waihekor/Rubik-Robot/README.md

# Rubik-Robot
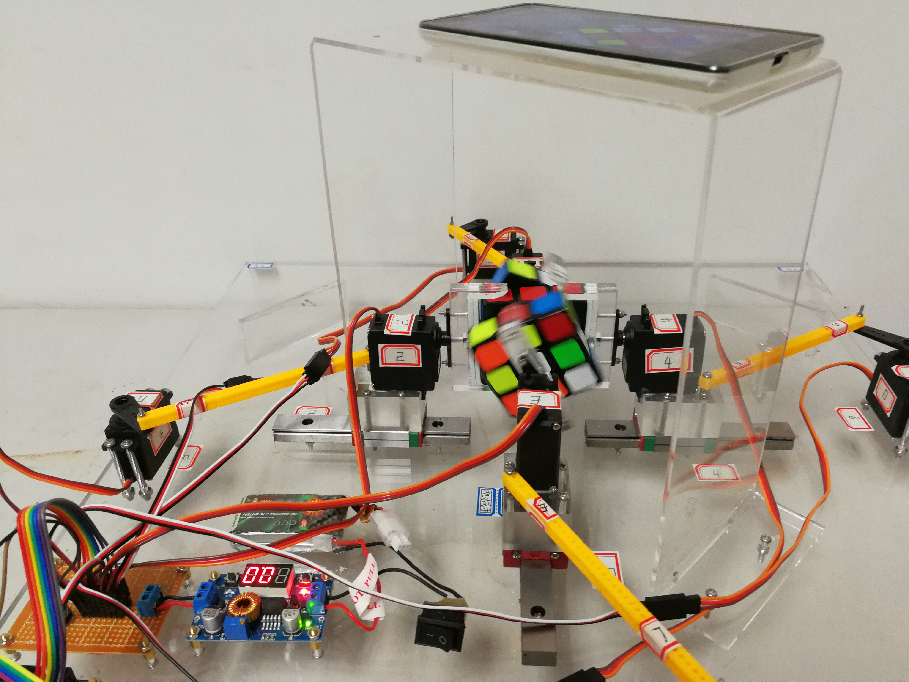
[picture p1: Photos/Robot/5.jpg]
