waihekor/Rubik-Robot/Drawing/亚克力定制要求.pdf

图纸中所有单位均为 mm，比例为 1：1， 机械手为黑色亚克力材质（ 考虑到

手机 APP 自动识别精度）， 其它为透明亚克力材质。

要求：

1.滑块增高块厚度为 30mm，数量 4 个。

2.机械手厚度为 10mm，数量 4 个。

3.手机支架厚度为 3mm，数量 1 个。（备注：需要弯折）

4.基板厚度为 8mm，数量 1 个。

5.基板支撑块， 数量 4 个。

备注：基板支撑块很简单，没有图纸，参考设计：长 100mm，宽 40mm，厚度

8mm。

# 子非鱼科技网店
