waihekor/Rubik-Robot/Drawing/其它/定制要求.pdf

图纸中所有单位均为 mm
要求：

1.机械手厚度为 10mm，数量 4 个。(透明亚克力)
2.基板厚度为 6mm，数量 1 个。 （透明亚克力） 3.最后一个很简单，没有图纸，长 100mm，宽 40mm，厚度 8mm。（透明亚克力）
