waihekor/Rubik-Robot/Algorithm/Automatic Identification/两种类型的魔方.pdf

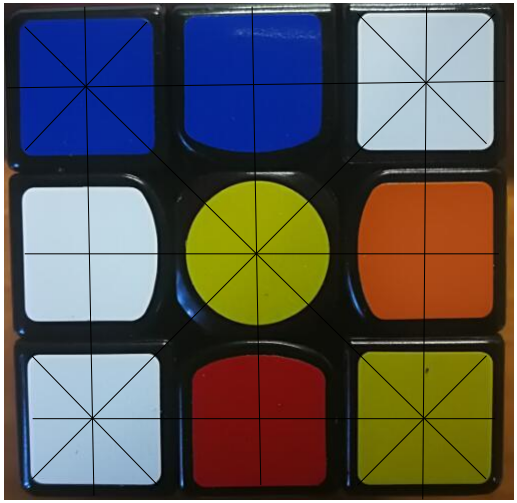
[picture p2: figure]

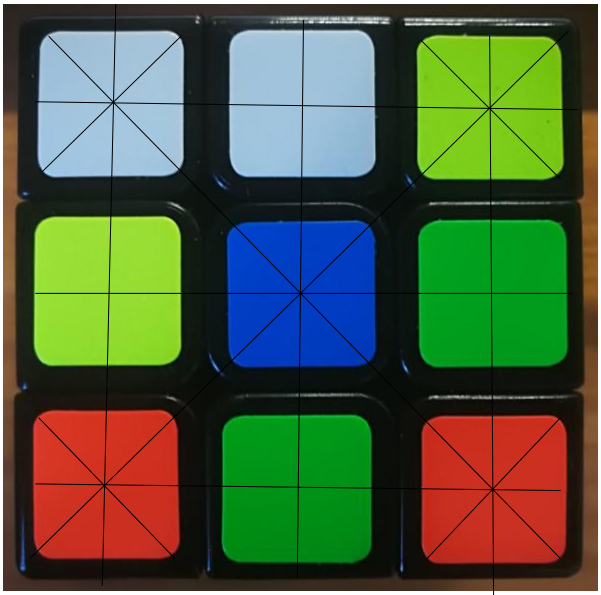
[picture p3: figure]
