waihekor/Rubik-Robot/Photos/Robot/1.jpg

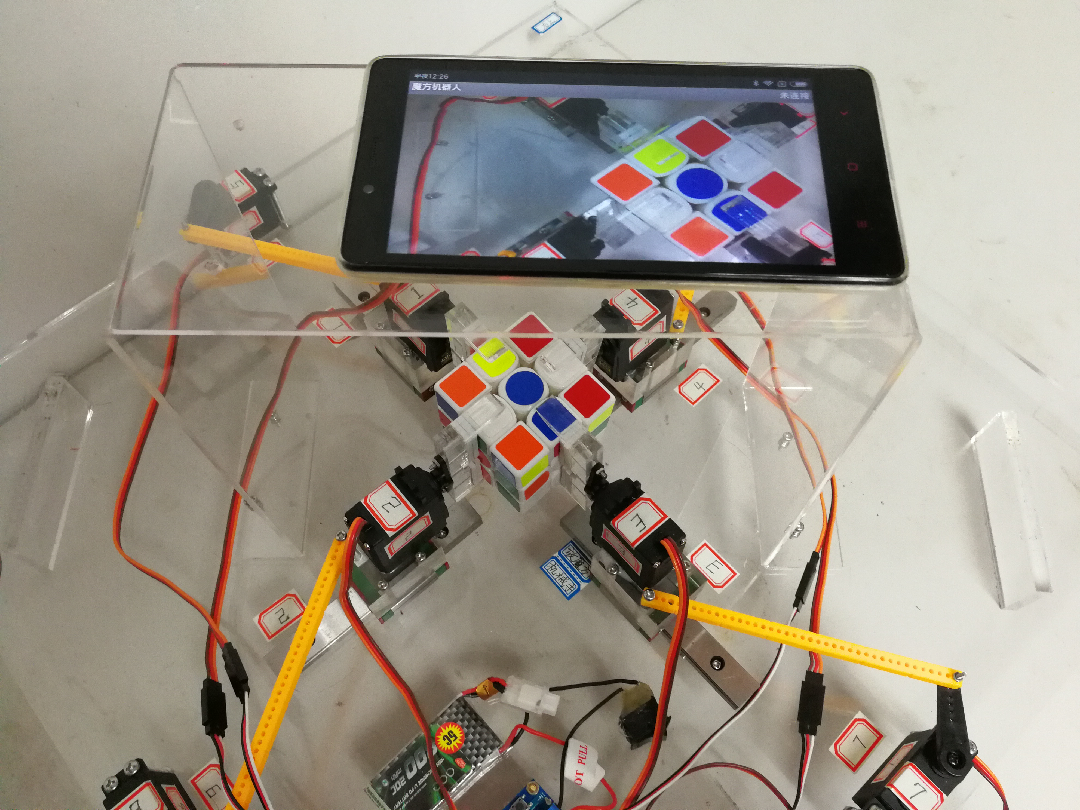
Photos/Robot/1.jpg
