waihekor/Rubik-Robot/Photos/Robot/2.jpg

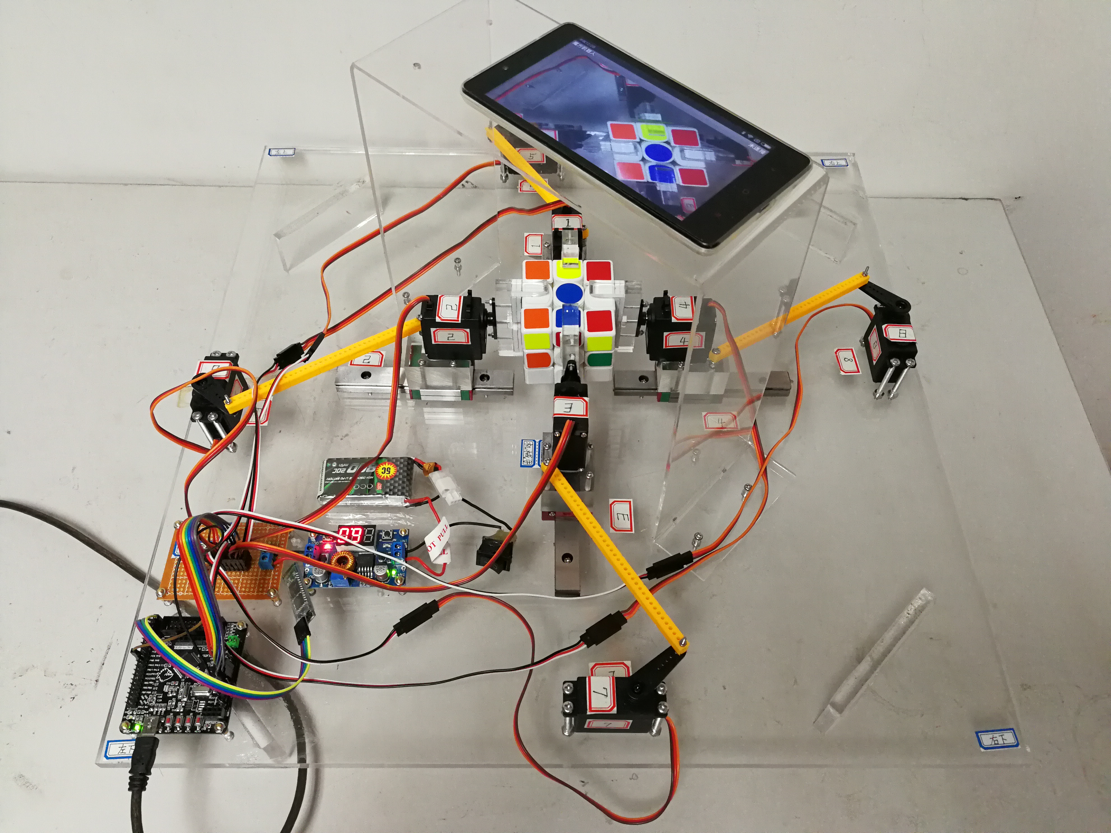
Photos/Robot/2.jpg
