waihekor/Rubik-Robot/Photos/Robot/3.jpg

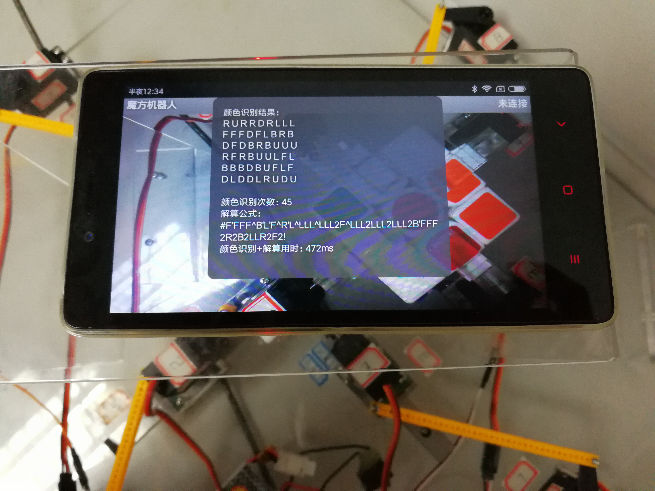
Photos/Robot/3.jpg
