waihekor/Rubik-Robot/Photos/Robot/4.jpg

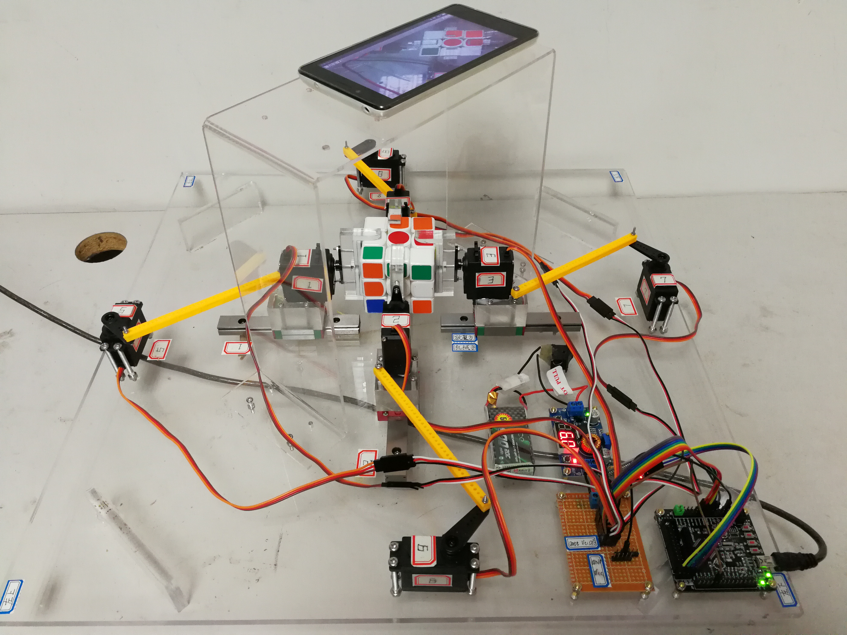
Photos/Robot/4.jpg
