waihekor/Rubik-Robot/Photos/SD Card/1.jpg

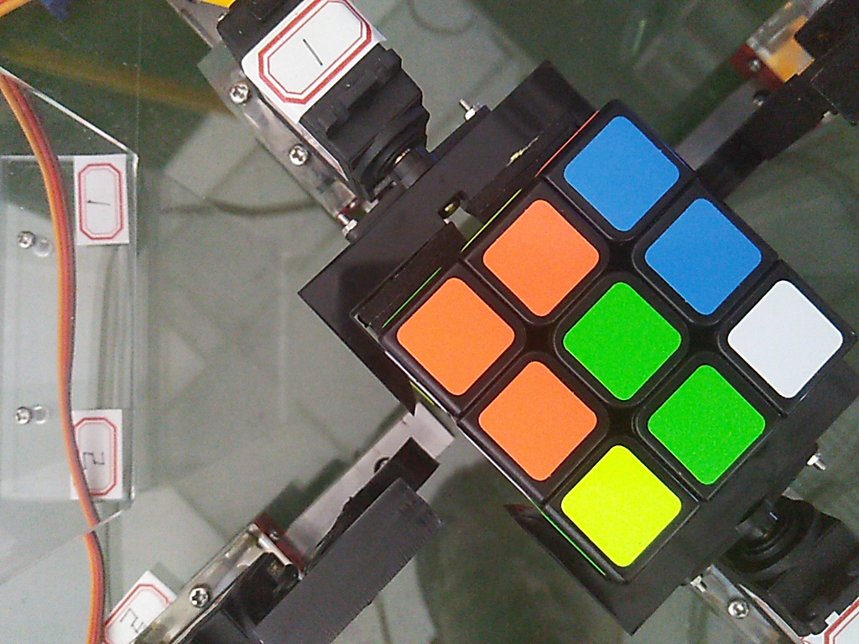
Photos/SD Card/1.jpg
