waihekor/Rubik-Robot/Photos/SD Card/2.jpg

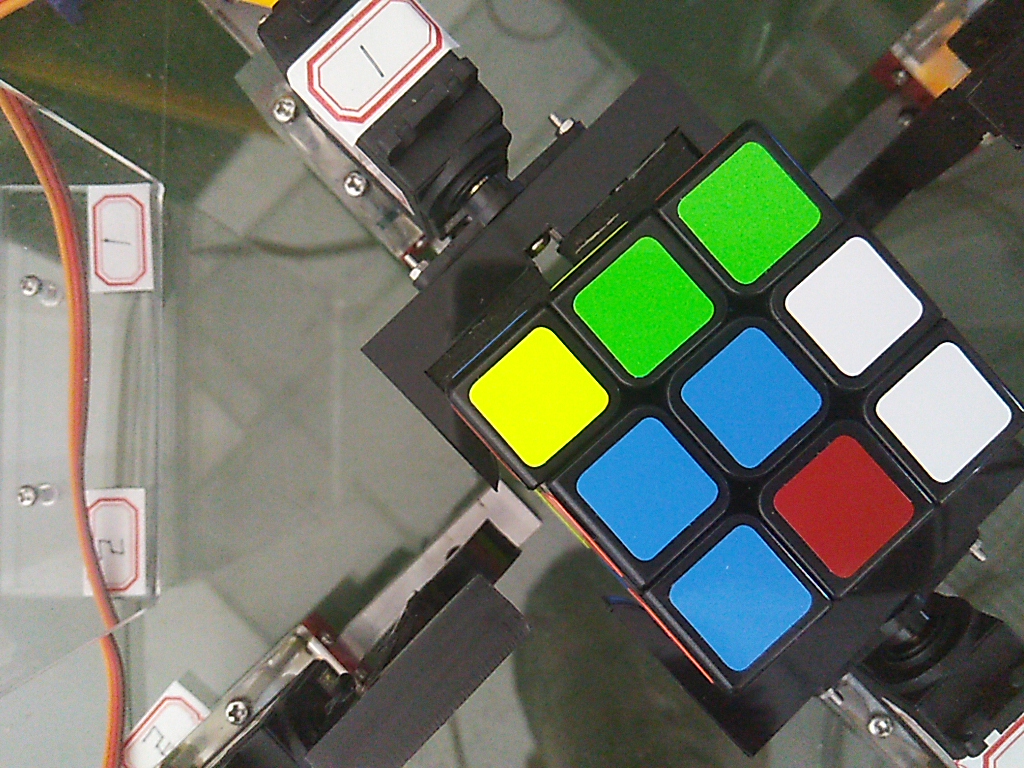
Photos/SD Card/2.jpg
