waihekor/Rubik-Robot/Photos/SD Card/3.jpg

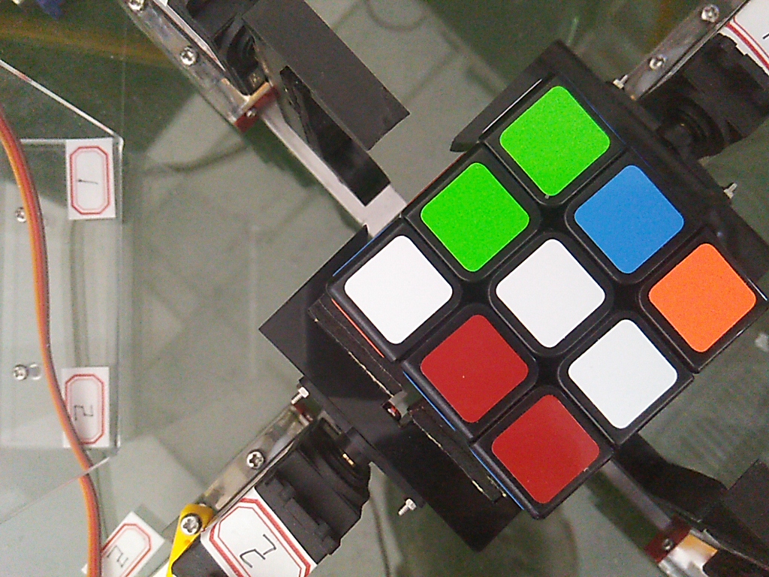
Photos/SD Card/3.jpg
