waihekor/Rubik-Robot/Photos/SD Card/4.jpg

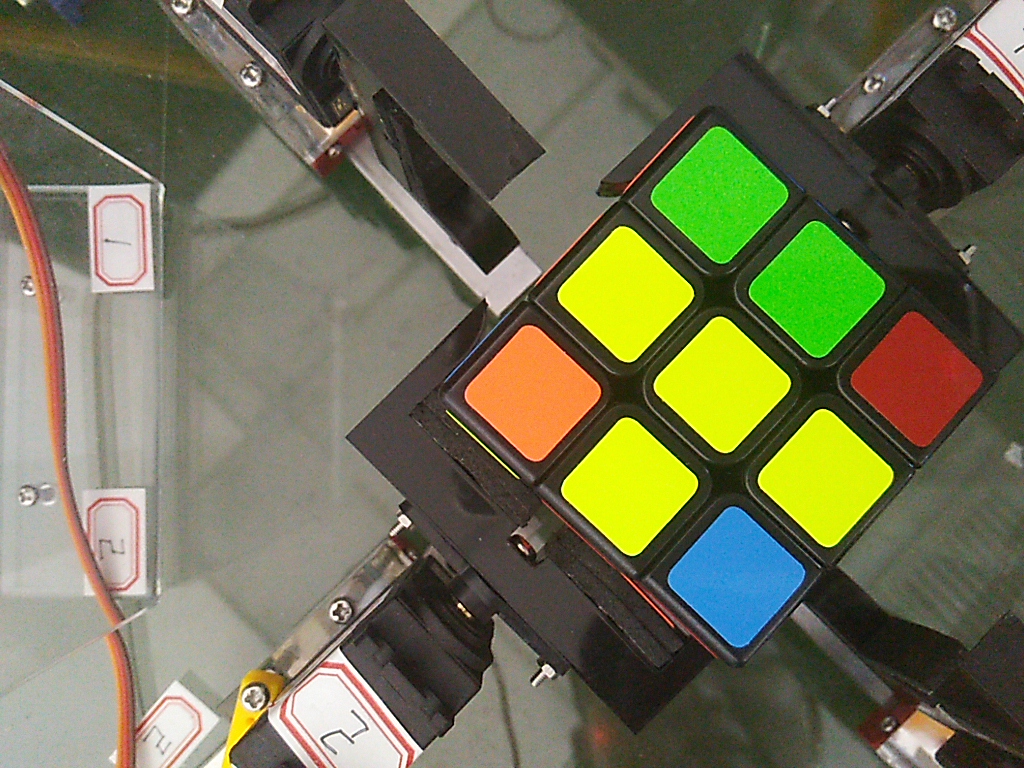
Photos/SD Card/4.jpg
