waihekor/Rubik-Robot/Photos/SD Card/5.jpg

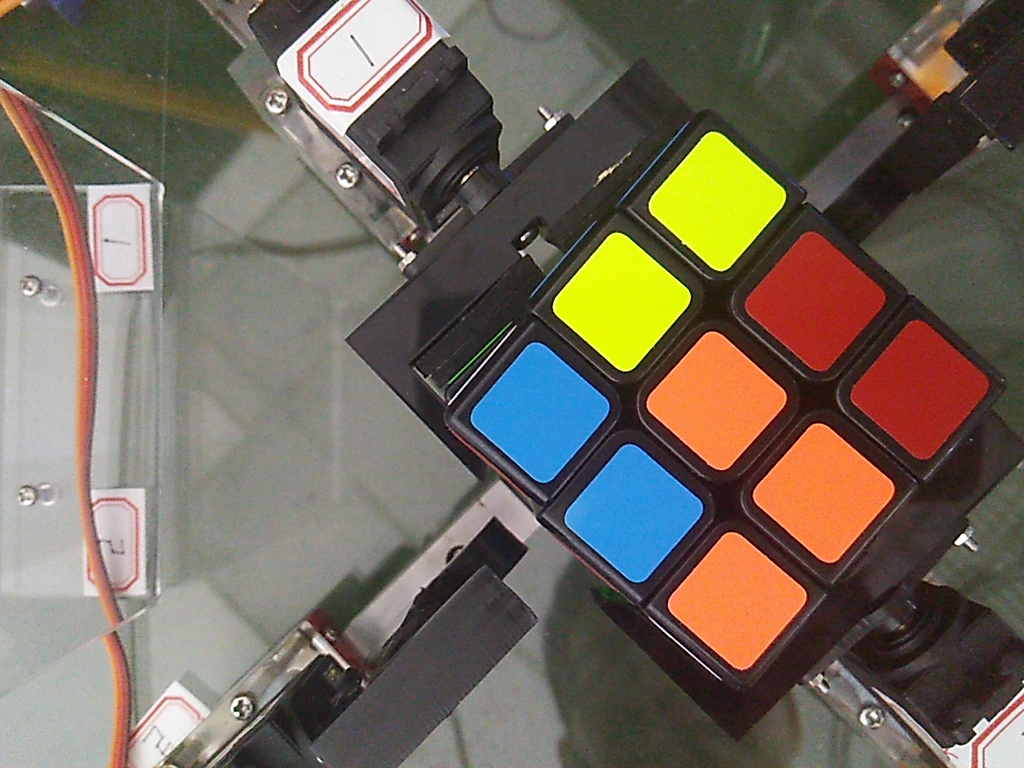
Photos/SD Card/5.jpg
