waihekor/Rubik-Robot/Photos/SD Card/6.jpg

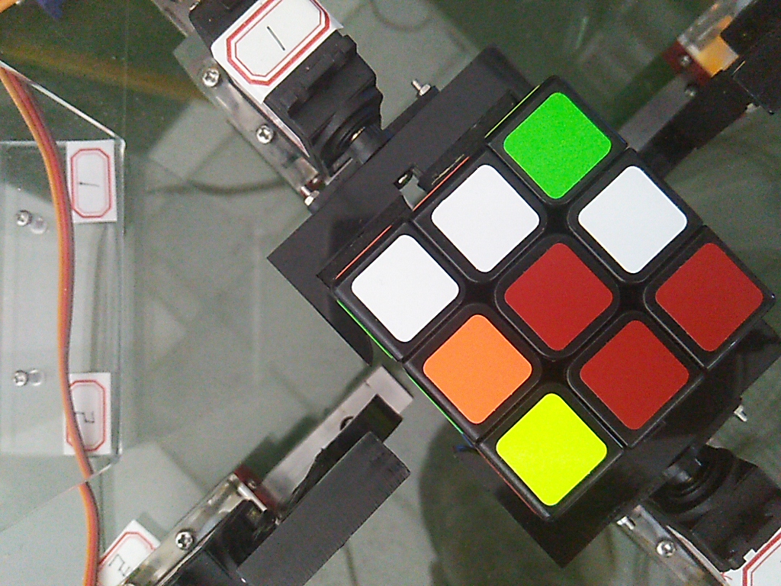
Photos/SD Card/6.jpg
