waihekor/Rubik-Robot/(list of files, cad)

Other CAD files:
Drawing/其它/机械手.DWG
Drawing/手机支架.DWG
Drawing/其它/基板.DWG
Drawing/机械手.DWG
Drawing/基板.DWG
Drawing/滑块增高块.DWG
