waihekor/Rubik-Robot/Tutorial/系统搭建/电路搭建/蓝牙串口模块设置教程.pdf

全套硬件套餐中使用的蓝牙串口模块型号为 HC-05，其采用蓝牙 2.0 通信协议。蓝牙串 口模块使用了蓝牙芯片的透传功能，可以实现蓝牙协议和串口协议之间的转换，不需要了解 蓝牙协议就可以实现数据的无线收发，非常方便，其也叫做无线串口。 蓝牙串口模块使用 AT 指令来设置其参数，例如蓝牙名称，蓝牙配对密码等。针对我们 的硬件套餐提供的蓝牙串口模块，下面我们介绍其参数设置方法，如果不对其参数进行设置， 蓝牙串口模块无法正常工作。我们提供的蓝牙串口模块如下图所示。

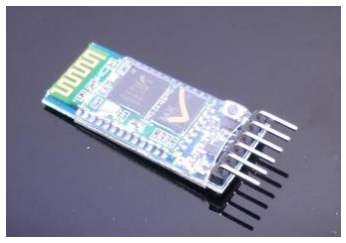
[picture p22: figure]
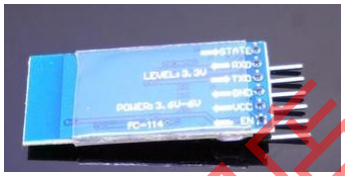
[picture p23: figure]

蓝牙串口模块正面 | 蓝牙串口模块背面

在设置前，我们需要准备一个 USB 转 TTL 模块，单片机下载程序一般会用到这种模块， 如下图所示。

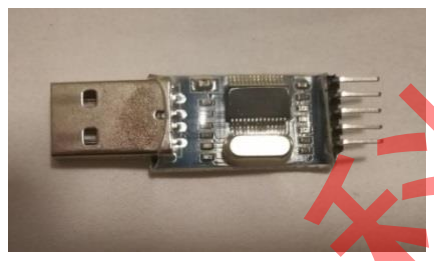
[picture p24: figure]
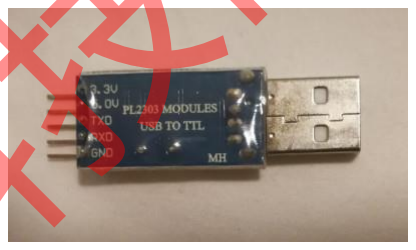
[picture p25: figure]

USB 转 TTL 模块正面 | USB 转 TTL 模块背面

第一步需要用杜邦线把 USB 转 TTL 模块和蓝牙串口模块连接在一起，各用双方的四根 线，分别为 VCC(5.0V)， GND(电源负极)，TXD(串口发送端口)，RXD（串口接收端口），双 方的连接方式为：

USB 转 TTL 模块 | 蓝牙串口模块
5.0V | POWER 3.6V-6.0V
GND | GND
TXD | RXD
RXD | TXD

第二步，按住蓝牙串口模块上的一个黑色按键，并把 USB 转 TTL 模块插在电脑的 USB 口上，直到蓝牙串口模块上的灯的状态由快闪变为慢闪，这时松开按键，此时就可以使用 AT 指令了。插上 USB 转 TTL 模块之后通过电脑设备管理器可以查询到串口端口号，如下图所 示，我们要记住这个端口号。

# 子非鱼科技网店

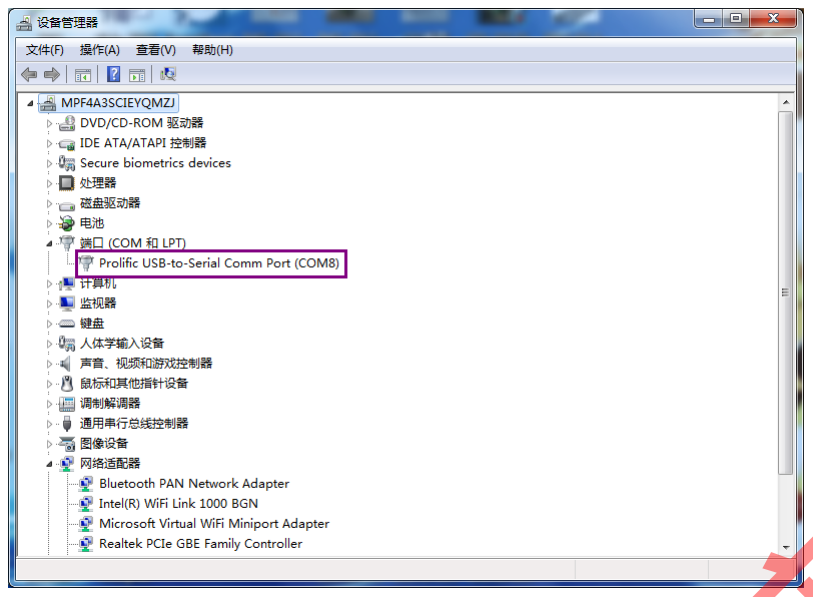
[picture p26: figure]
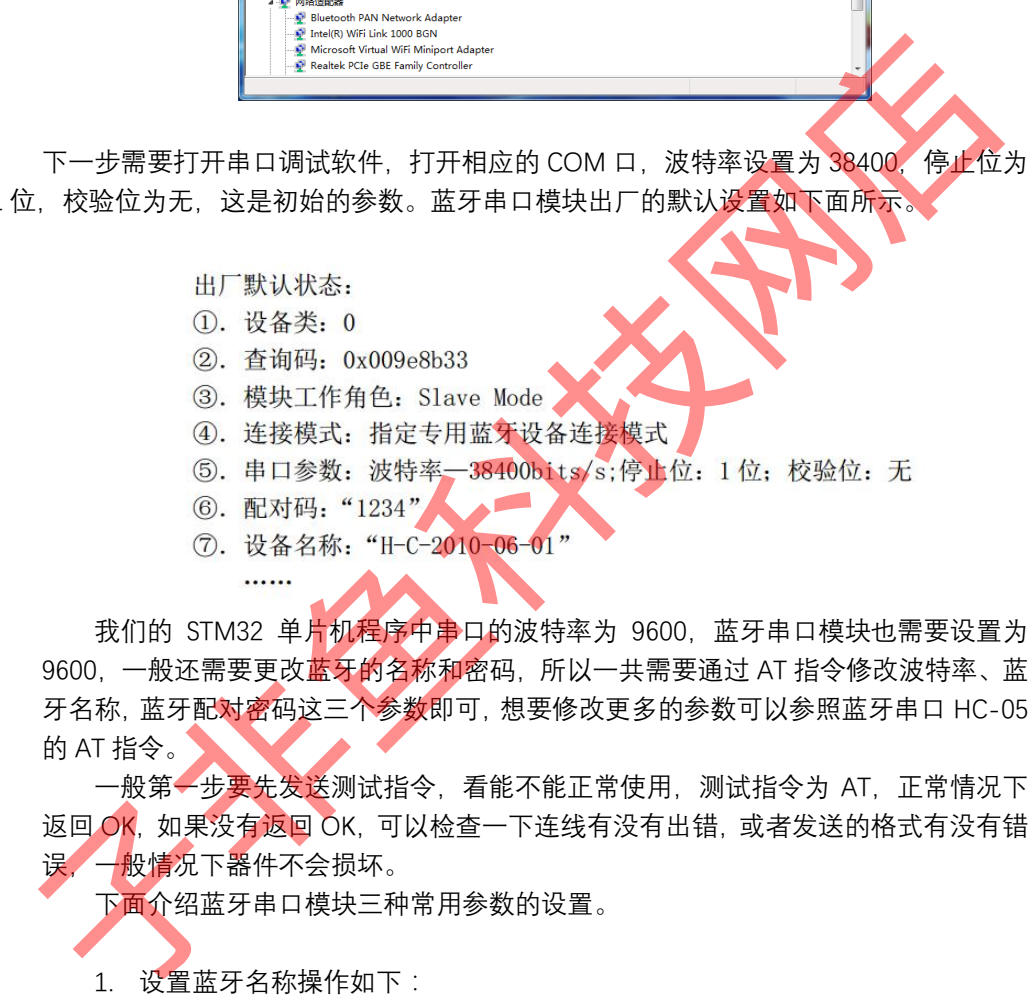
[picture p27: figure]
子非鱼科技网店; 设置蓝牙名称操作如下：

下一步需要打开串口调试软件，打开相应的 COM 口，波特率设置为 38400，停止位为 1 位，校验位为无，这是初始的参数。蓝牙串口模块出厂的默认设置如下面所示。

我们的 STM32 单片机程序中串口的波特率为 9600，蓝牙串口模块也需要设置为 9600，一般还需要更改蓝牙的名称和密码，所以一共需要通过 AT 指令修改波特率、蓝 牙名称，蓝牙配对密码这三个参数即可，想要修改更多的参数可以参照蓝牙串口 HC-05 的 AT 指令。
一般第一步要先发送测试指令，看能不能正常使用，测试指令为 AT，正常情况下 返回 OK，如果没有返回 OK，可以检查一下连线有没有出错，或者发送的格式有没有错 误，一般情况下器件不会损坏。
下面介绍蓝牙串口模块三种常用参数的设置。

1.

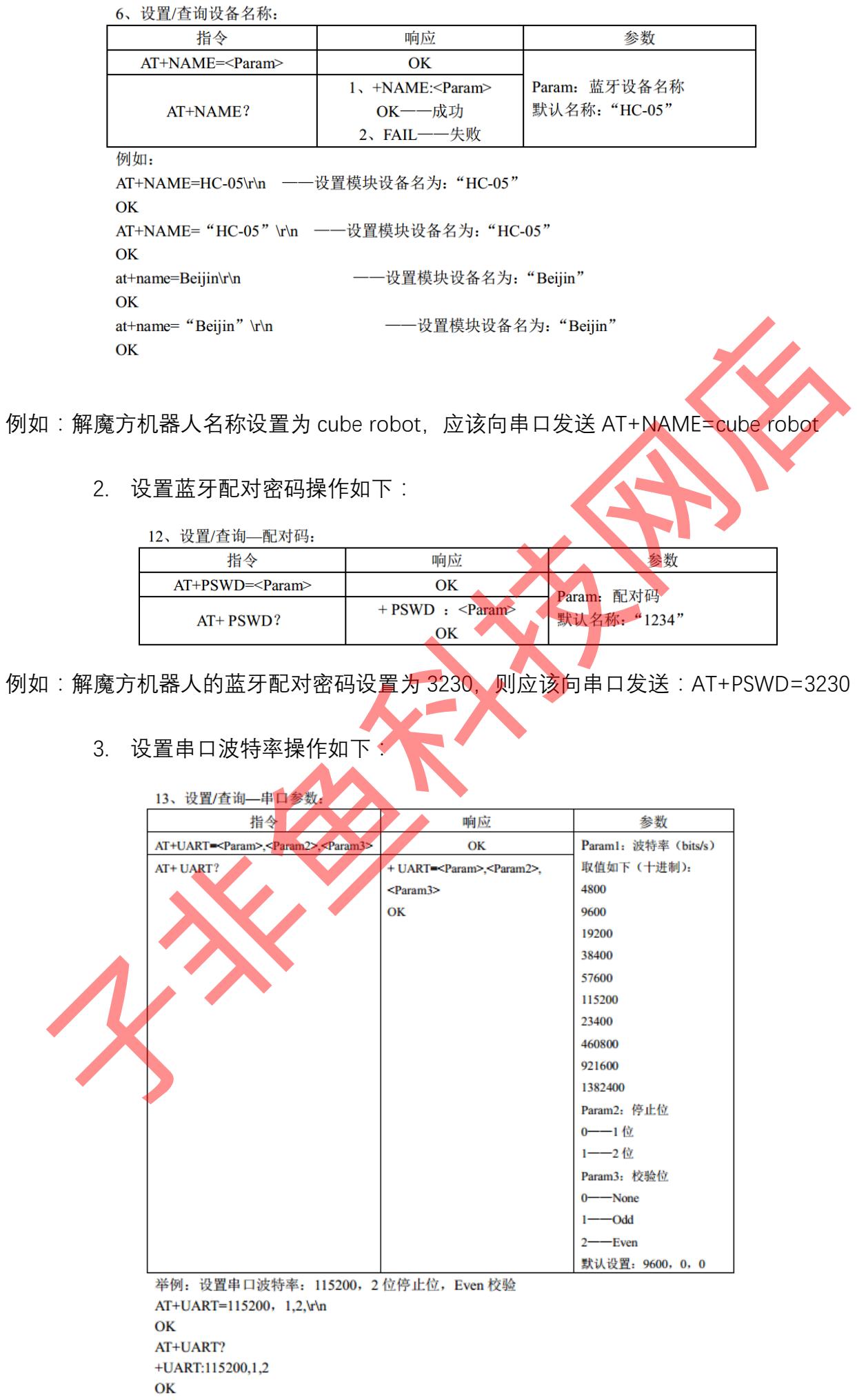
[picture p28: page 3]

例如：解魔方机器人名称设置为 cube robot，应该向串口发送 AT+NAME=cube robot

2. 设置蓝牙配对密码操作如下：

例如：解魔方机器人的蓝牙配对密码设置为 3230，则应该向串口发送：AT+PSWD=3230

3. 设置串口波特率操作如下：

# 子非鱼科技网店

例如：解魔方机器人的串口波特率设置为 9600，应该向串口发送： AT+UART=9600,0,0

# 子非鱼科技网店
