waihekor/Rubik-Robot/Tutorial/系统搭建/电路搭建/解魔方机器人电路介绍与搭建教程.pdf

整个解魔方机器人的电路系统由以下几部分组成：STM32 最小系统板、舵机插接板、锂 电池、蓝牙串口模块、大电流稳压模块，舵机，各个模块的图片如下图所示。

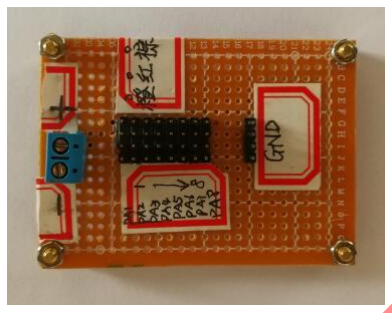
[picture p29: figure]
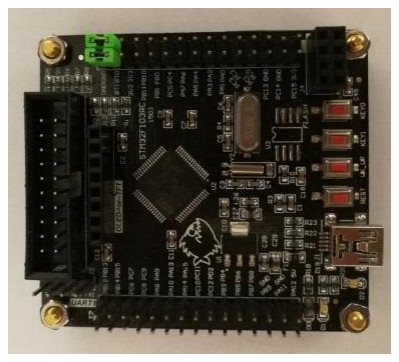
[picture p30: figure]

STM32 最小系统板 | 舵机插接板

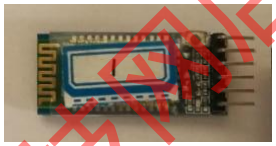
[picture p31: figure]
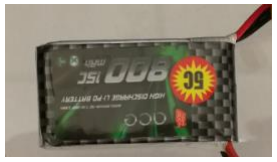
[picture p32: figure]

锂电池 | 蓝牙串口模块

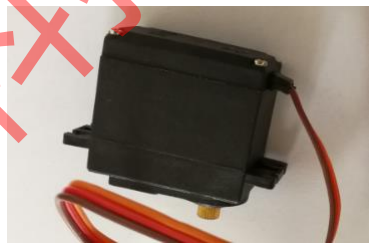
[picture p33: figure]
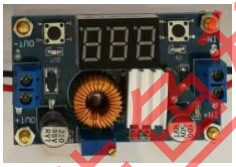
[picture p34: figure]

大电流稳压模块 | 舵机

解魔方机器人有两套电源供应系统，锂电池通过大电流稳压模块单独为舵机供电，USB 数据线为 STM32 最小系统板供电。
锂电池的标称电压为 7.2V，充满电可以达到 8V 以上，最大输出电流可达 12A，完全可 以满足舵机驱动的电流和压电要求。
MG995 舵机的供电电压一般为 4.8V-7.2V，每个舵机在工作时的电流要大于 500mA，8 个舵机需要至少 4A 的电流，全套硬件套餐中提供的大电流稳压模块能够提供最大 5A 的电 流，该款稳压模块可以通过调节电位器调节输出电压的值，电位器顺时针为升压，逆时针为 降压，我们一般调节输出电压到 6V，关于该款稳压模块更多功能的介绍见下图。

# 子非鱼科技网店

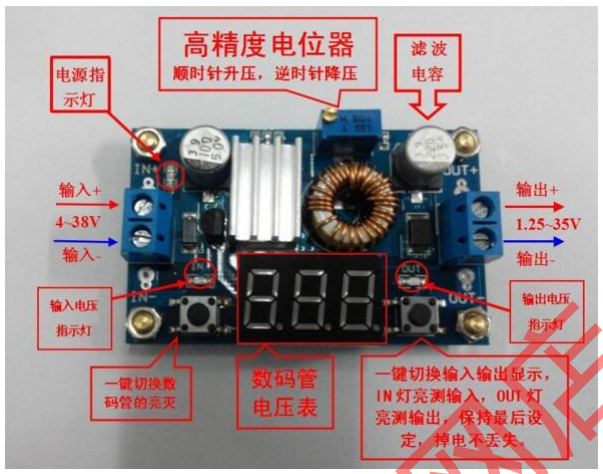
[picture p35: figure]

大电流稳压模块功能介绍

舵机有三根线，橙色为数据线，红色为电源正极，棕色为电源负极，数据线需要连接 STM32 相应端口，通过编程让 STM32 来控制其角度。舵机插接板为洞洞板手工焊接，正面 和背面如图所示。

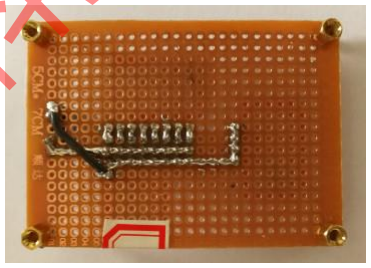
[picture p36: figure]
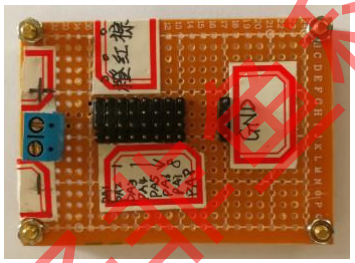
[picture p37: figure]

插接板正面 | 插接板背面

图中从左到右，1 号舵机到 8 号舵机的数据线分别连接 STM32 的 PA1 到 PA8，锂电池 的电源地和 STM32 的地可以不用连接，这样锂电池电源和 STM32 供电系统没有任何耦合， 即上图中的标识 GND 可以不用。从图中可以很清晰看到，从上到下有四排排针，每排有 8 根，对应 8 个舵机。前三排排针连接舵机用，从上到下分别连接舵机的电源负极、电源正极 和数据线，可以看到第三排排针和第四排排针是上面相通的，第四排排针是通过杜邦线把舵 机的数据线和单片机的 P 对应端口相连。舵机和舵机插接板的连接示意图如下图所示。

# 子非鱼科技网店

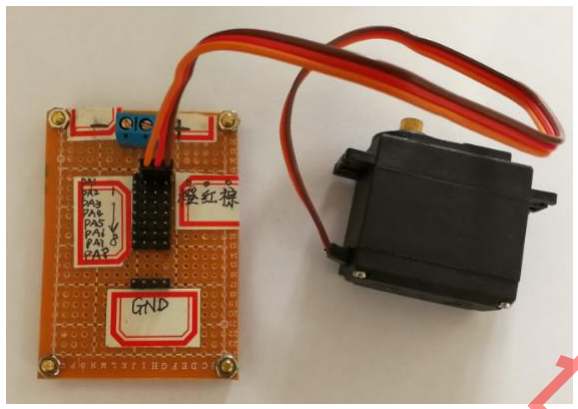
[picture p38: figure]
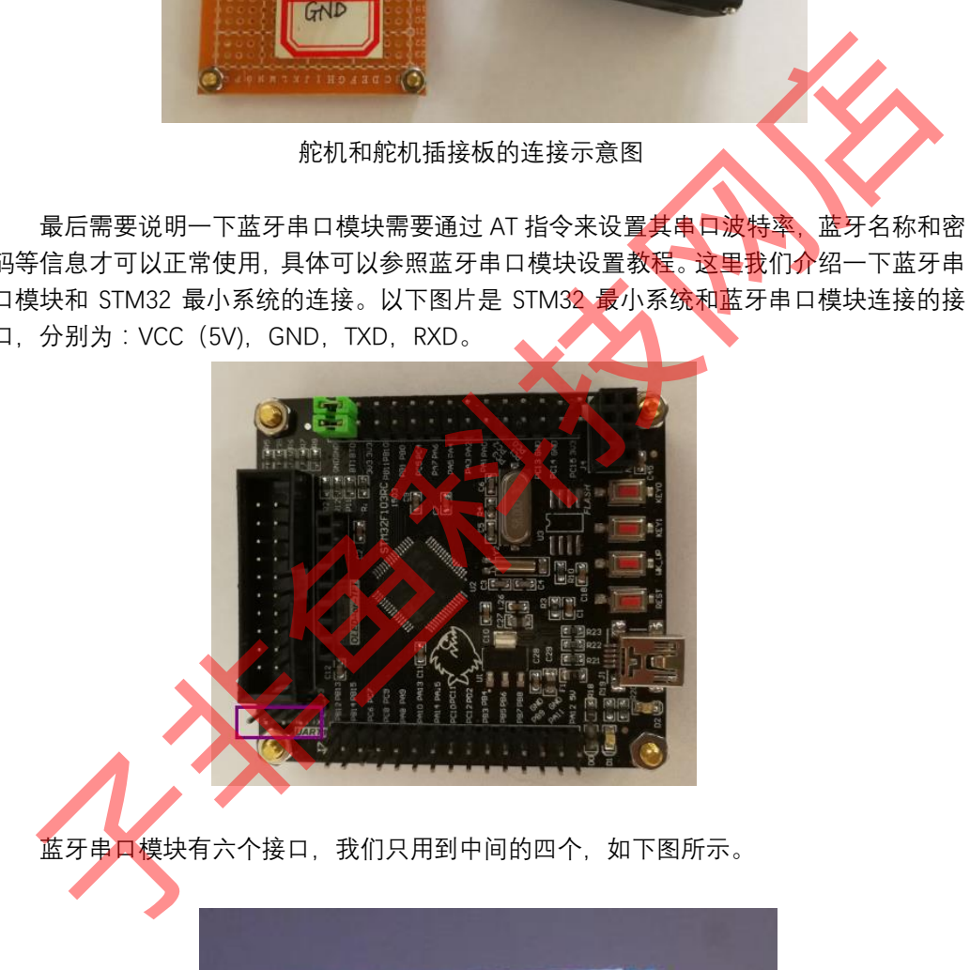
[picture p39: figure]
子非鱼科技网店

舵机和舵机插接板的连接示意图

最后需要说明一下蓝牙串口模块需要通过 AT 指令来设置其串口波特率，蓝牙名称和密 码等信息才可以正常使用，具体可以参照蓝牙串口模块设置教程。这里我们介绍一下蓝牙串 口模块和 STM32 最小系统的连接。以下图片是 STM32 最小系统和蓝牙串口模块连接的接 口，分别为：VCC（5V)，GND，TXD，RXD。

蓝牙串口模块有六个接口，我们只用到中间的四个，如下图所示。

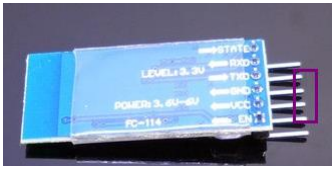
[picture p40: figure]

两者的连接关系为：

VCC-------------------------------VCC GND---------------------------- --GND TXD-------------------------------RXD RXD-------------------------------TXD

两者用杜邦线连接起来，杜邦线是一一对应的，并不存在杜邦线交叉的情况，线路连接 还是比价清晰的。

# 子非鱼科技网店
