waihekor/Rubik-Robot/Tutorial/视频教程/解魔方机器人有关视频.pdf

解魔方机器人工作视频

第一版解魔方机器人
http://v.youku.com/v_show/id_XMTY1MjY4MDY4MA==.html?spm=a2hzp.8253869.0.0

解魔方机器人安卓手机新版
http://v.youku.com/v_show/id_XMjc3MjIwNjE0OA==.html?spm=a2hzp.8253869.0.0

其他解魔方机器人工作视频
http://v.youku.com/v_show/id_XMTY4MjE3MDIzMg==.html?spm=a2hzp.8253869.0.0

http://v.youku.com/v_show/id_XMjY2NjMzODk0MA==.html?spm=a2hzp.8253869.0.0

解魔方机器人视频教程

解魔方机器人安装视频
http://v.youku.com/v_show/id_XMjc1NDM4OTg2NA==.html?spm=a2hzp.8253869.0.0 密码：123654

解魔方介绍和操作视频
http://v.youku.com/v_show/id_XMjc1MzQ5NTk0MA==.html?spm=a2hzp.8253869.0.0 密码：123654

有关魔方自动识别框算法

魔方图片 HSV 色域演示视频
http://v.youku.com/v_show/id_XMjg3MzMzMTg5Mg==.html?spm=a2hzp.8253869.0.0

魔方（中间正方形）自动识别框算法仿真
http://v.youku.com/v_show/id_XMjg3MzMyNTAwOA==.html?spm=a2hzp.8253869.0.0

（后续更新

# 子非鱼科技网店 ~~~~）
