waihekor/Rubik-Robot/Algorithm/Automatic Identification/k-means效果.pdf

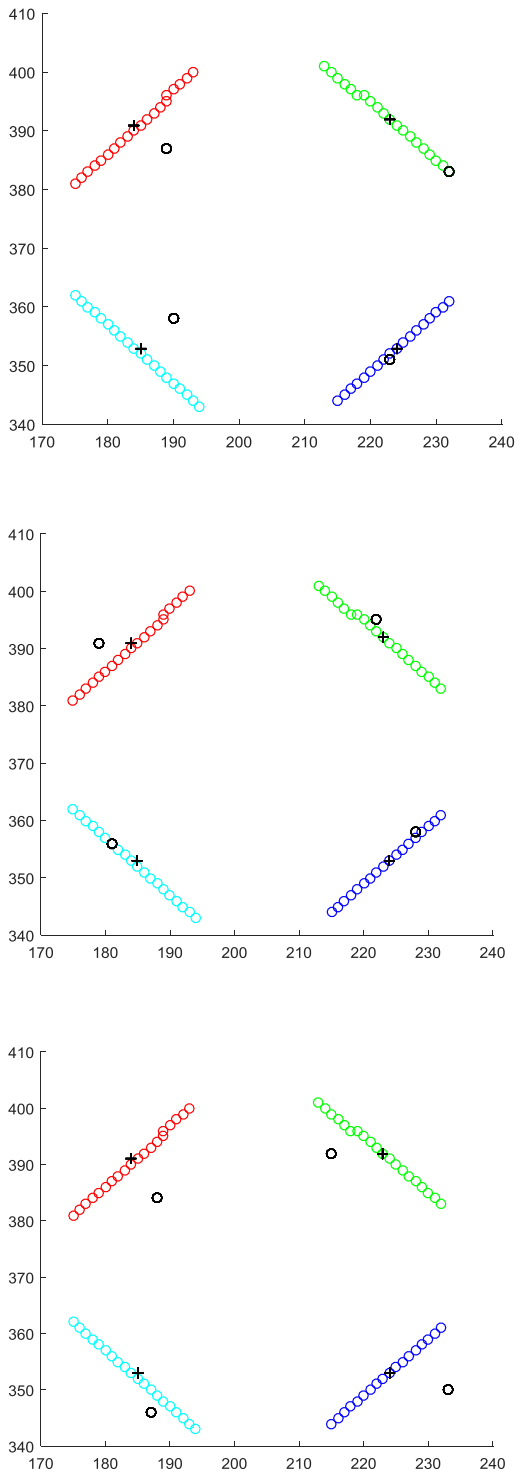
[picture p50: page 1]
