waihekor/Rubik-Robot/Code/Cube Robot_STM32/HARDWARE/TIMER/timer.h

#ifndef __TIMER_H
#define __TIMER_H
#include "sys.h"

extern u8 flag_vpwm; /*插补标志位*/
extern u8 end_flag;//魔方复原完成标志位
extern u8 send_start_flag;
void TIM3_Int_Init(u16 arr,u16 psc);
void TIM4_Int_Init(u16 arr,u16 psc);



void TIM3_Set_Time(u16 arr);
void TIM4_Set_Time(u16 arr);

 
#endif
